darakuneko/kb_bridge/docs/hardware/kb_bridge_v0.7_dimensions.pdf

X

Y

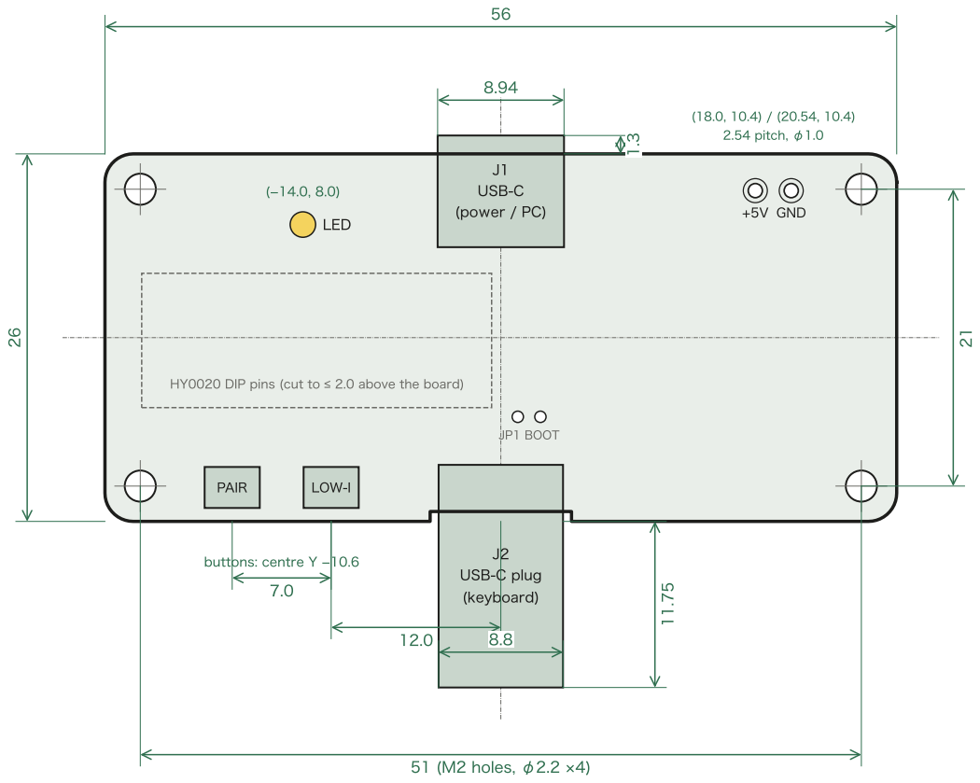
[picture p1: figure]
J1 USB-C; (power / PC); USB-C plug; (keyboard); PAIR; LOW-I; LED; +5V GND; JP1 BOOT; buttons: centre Y −10.6; (18.0, 10.4) / (20.54, 10.4) 2.54 pitch, φ1.0; 51 (M2 holes, φ2.2 ×4)

HY0020 DIP pins (cut to ≤ 2.0 above the board)

## Top view (component side)

## Side view (Y–Z, keyboard side left)

Origin

board centre, X right, +Y towards J1, Z = board bottom (0)

STL

kb_bridge_v0.7_pcba.stl: same frame (mm), HY0020 fitted

Board

56.0 × 26.0 × 1.6, corner R2.0, notch 10 × 0.7 behind J2

Mounting
4 × φ2.2 (M2) at (±25.5, ±10.5)

J1 power / PC

USB-C receptacle, front face Y +14.3 (1.3 out of the edge), Z 0.74–4.85

J2 keyboard
USB-C plug, tip Y −24.75 (11.75 out of the edge), Z 0.29–3.20, centre Z 1.75

Top side

tallest: J1 4.85, buttons 3.54 (TS-1088, pressed from the top), LED 2.70

Bottom
HY0020 DIP board + module down to Z −2.14; keep Z −2.9 free

5V / GND
two φ1.0 holes, 2.54 pitch at (18.0, 10.4) +5V and

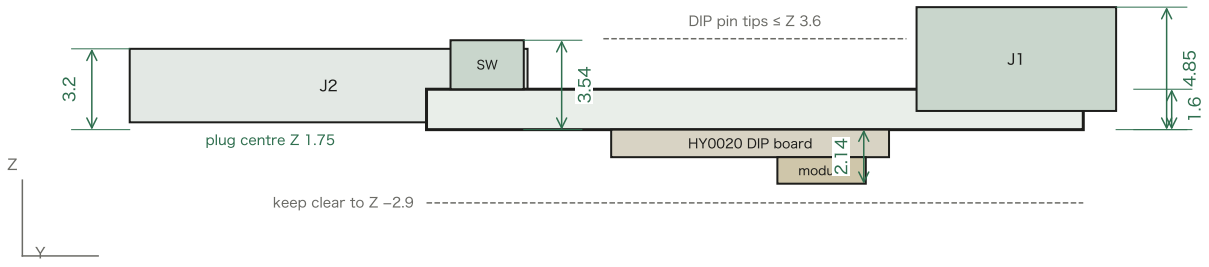
[picture p2: figure]
HY0020 DIP board; module; keep clear to Z −2.9; DIP pin tips ≤ Z 3.6; plug centre Z 1.75

(20.54, 10.4) GND:
power without J1 (4.5–5.5 V; same input as J1,

reverse-protected)

LED
bi-colour (red / green) at (−14.0, 8.0) on the top

side: leave a light hole

Antenna

keep metal away from the HY0020 module (bottom side, Y +0.9 … +4.4)

# KB Bridge v0.7 — PCBA dimensions
