darakuneko/kb_bridge/THIRD_PARTY_NOTICES.md

# Third-party notices

KB Bridge itself is MIT licensed (see `LICENSE`). The firmware binaries published in `docs/firmware/`
also contain the third-party software below; their licenses follow.

- **nRF52832 firmware** (`kb_bridge_*.zip`): built with the Adafruit nRF52 Arduino core 1.7.0 and the
  libraries listed here. The LGPL-2.1 parts of the core are linked statically; the complete source of
  KB Bridge (this repository) and of the core (link below) are public, so the firmware can be rebuilt
  and relinked with a modified core (`fw/build.sh`).
- **CH559 firmware** (`kb_bridge_ch559_*.bin`, also embedded in the nRF firmware): KB Bridge code only,
  built with SDCC; the SDCC runtime library is GPL with a linking exception, which places no conditions
  on the firmware.
- The Nordic SoftDevice and the Adafruit bootloader come pre-installed on the AE-HY0020-DIP and are not
  part of these files (only the SoftDevice API headers are used at build time).

| Component | License | Source |
|---|---|---|
| Adafruit nRF52 Arduino core 1.7.0 (Arduino core files) | LGPL-2.1-or-later | https://github.com/adafruit/Adafruit_nRF52_Arduino |
| Bluefruit52Lib (Adafruit nRF52 core) | MIT | https://github.com/adafruit/Adafruit_nRF52_Arduino |
| InternalFileSystem / Adafruit_LittleFS (Adafruit nRF52 core) | MIT | https://github.com/adafruit/Adafruit_nRF52_Arduino |
| littlefs | BSD-3-Clause | https://github.com/littlefs-project/littlefs |
| FreeRTOS kernel | MIT | https://www.freertos.org |
| Nordic nrfx / MDK | BSD-3-Clause | https://github.com/NordicSemiconductor/nrfx |
| Nordic SoftDevice S132 6.1.1 API headers | Nordic 5-Clause | https://www.nordicsemi.com |

## Adafruit nRF52 Arduino core 1.7.0 (Arduino core files)

License: LGPL-2.1-or-later. Source: https://github.com/adafruit/Adafruit_nRF52_Arduino

```
Copyright (c) 2015 Arduino LLC.  All right reserved.
Copyright (c) 2016 Sandeep Mistry All right reserved.
Copyright (c) 2017 Adafruit Industries. All rights reserved.

This library is free software; you can redistribute it and/or
modify it under the terms of the GNU Lesser General Public
License as published by the Free Software Foundation; either
version 2.1 of the License, or (at your option) any later version.

This library is distributed in the hope that it will be useful,
but WITHOUT ANY WARRANTY; without even the implied warranty of
MERCHANTABILITY or FITNESS FOR A PARTICULAR PURPOSE.
See the GNU Lesser General Public License for more details.

You should have received a copy of the GNU Lesser General Public
License along with this library; if not, write to the Free Software
Foundation, Inc., 51 Franklin St, Fifth Floor, Boston, MA  02110-1301  USA

Full text: licenses/LGPL-2.1.txt
```

## Bluefruit52Lib (Adafruit nRF52 core)

License: MIT. Source: https://github.com/adafruit/Adafruit_nRF52_Arduino

```
MIT License

Copyright (c) 2016 Adafruit Industries

Permission is hereby granted, free of charge, to any person obtaining a copy
of this software and associated documentation files (the "Software"), to deal
in the Software without restriction, including without limitation the rights
to use, copy, modify, merge, publish, distribute, sublicense, and/or sell
copies of the Software, and to permit persons to whom the Software is
furnished to do so, subject to the following conditions:

The above copyright notice and this permission notice shall be included in all
copies or substantial portions of the Software.

THE SOFTWARE IS PROVIDED "AS IS", WITHOUT WARRANTY OF ANY KIND, EXPRESS OR
IMPLIED, INCLUDING BUT NOT LIMITED TO THE WARRANTIES OF MERCHANTABILITY,
FITNESS FOR A PARTICULAR PURPOSE AND NONINFRINGEMENT. IN NO EVENT SHALL THE
AUTHORS OR COPYRIGHT HOLDERS BE LIABLE FOR ANY CLAIM, DAMAGES OR OTHER
LIABILITY, WHETHER IN AN ACTION OF CONTRACT, TORT OR OTHERWISE, ARISING FROM,
OUT OF OR IN CONNECTION WITH THE SOFTWARE OR THE USE OR OTHER DEALINGS IN THE
SOFTWARE.
```

## InternalFileSystem / Adafruit_LittleFS (Adafruit nRF52 core)

License: MIT. Source: https://github.com/adafruit/Adafruit_nRF52_Arduino

```
The MIT License (MIT)

Copyright (c) 2019 Ha Thach for Adafruit Industries

Permission is hereby granted, free of charge, to any person obtaining a copy
of this software and associated documentation files (the "Software"), to deal
in the Software without restriction, including without limitation the rights
to use, copy, modify, merge, publish, distribute, sublicense, and/or sell
copies of the Software, and to permit persons to whom the Software is
furnished to do so, subject to the following conditions:

The above copyright notice and this permission notice shall be included in
all copies or substantial portions of the Software.

THE SOFTWARE IS PROVIDED "AS IS", WITHOUT WARRANTY OF ANY KIND, EXPRESS OR
IMPLIED, INCLUDING BUT NOT LIMITED TO THE WARRANTIES OF MERCHANTABILITY,
FITNESS FOR A PARTICULAR PURPOSE AND NONINFRINGEMENT. IN NO EVENT SHALL THE
AUTHORS OR COPYRIGHT HOLDERS BE LIABLE FOR ANY CLAIM, DAMAGES OR OTHER
LIABILITY, WHETHER IN AN ACTION OF CONTRACT, TORT OR OTHERWISE, ARISING FROM,
OUT OF OR IN CONNECTION WITH THE SOFTWARE OR THE USE OR OTHER DEALINGS IN
THE SOFTWARE.
```

## littlefs

License: BSD-3-Clause. Source: https://github.com/littlefs-project/littlefs

```
Copyright (c) 2017, Arm Limited. All rights reserved.

Redistribution and use in source and binary forms, with or without modification,
are permitted provided that the following conditions are met:

-  Redistributions of source code must retain the above copyright notice, this
   list of conditions and the following disclaimer.
-  Redistributions in binary form must reproduce the above copyright notice, this
   list of conditions and the following disclaimer in the documentation and/or
   other materials provided with the distribution.
-  Neither the name of ARM nor the names of its contributors may be used to
   endorse or promote products derived from this software without specific prior
   written permission.

THIS SOFTWARE IS PROVIDED BY THE COPYRIGHT HOLDERS AND CONTRIBUTORS "AS IS" AND
ANY EXPRESS OR IMPLIED WARRANTIES, INCLUDING, BUT NOT LIMITED TO, THE IMPLIED
WARRANTIES OF MERCHANTABILITY AND FITNESS FOR A PARTICULAR PURPOSE ARE
DISCLAIMED. IN NO EVENT SHALL THE COPYRIGHT HOLDER OR CONTRIBUTORS BE LIABLE FOR
ANY DIRECT, INDIRECT, INCIDENTAL, SPECIAL, EXEMPLARY, OR CONSEQUENTIAL DAMAGES
(INCLUDING, BUT NOT LIMITED TO, PROCUREMENT OF SUBSTITUTE GOODS OR SERVICES;
LOSS OF USE, DATA, OR PROFITS; OR BUSINESS INTERRUPTION) HOWEVER CAUSED AND ON
ANY THEORY OF LIABILITY, WHETHER IN CONTRACT, STRICT LIABILITY, OR TORT
(INCLUDING NEGLIGENCE OR OTHERWISE) ARISING IN ANY WAY OUT OF THE USE OF THIS
SOFTWARE, EVEN IF ADVISED OF THE POSSIBILITY OF SUCH DAMAGE.
```

## FreeRTOS kernel

License: MIT. Source: https://www.freertos.org

```
The FreeRTOS kernel is released under the MIT open source license, the text of
which is provided below.

This license covers the FreeRTOS kernel source files, which are located in the
/FreeRTOS/Source directory of the official FreeRTOS kernel download.  It also
covers most of the source files in the demo application projects, which are
located in the /FreeRTOS/Demo directory of the official FreeRTOS download.  The
demo projects may also include third party software that is not part of FreeRTOS
and is licensed separately to FreeRTOS.  Examples of third party software
includes header files provided by chip or tools vendors, linker scripts,
peripheral drivers, etc.  All the software in subdirectories of the /FreeRTOS
directory is either open source or distributed with permission, and is free for
use.  For the avoidance of doubt, refer to the comments at the top of each
source file.

License text:
-------------

Copyright (C) 2017 Amazon.com, Inc. or its affiliates.  All Rights Reserved.
Permission is hereby granted, free of charge, to any person obtaining a copy of
this software and associated documentation files (the "Software"), to deal in
the Software without restriction, including without limitation the rights to
use, copy, modify, merge, publish, distribute, sublicense, and/or sell copies of
the Software, and to permit persons to whom the Software is furnished to do so,
subject to the following conditions:

The above copyright notice and this permission notice shall be included in all
copies or substantial portions of the Software.

THE SOFTWARE IS PROVIDED "AS IS", WITHOUT WARRANTY OF ANY KIND, EXPRESS OR
IMPLIED, INCLUDING BUT NOT LIMITED TO THE WARRANTIES OF MERCHANTABILITY, FITNESS
FOR A PARTICULAR PURPOSE AND NONINFRINGEMENT. IN NO EVENT SHALL THE AUTHORS OR
COPYRIGHT HOLDERS BE LIABLE FOR ANY CLAIM, DAMAGES OR OTHER LIABILITY, WHETHER
IN AN ACTION OF CONTRACT, TORT OR OTHERWISE, ARISING FROM, OUT OF OR IN
CONNECTION WITH THE SOFTWARE OR THE USE OR OTHER DEALINGS IN THE SOFTWARE.
```

## Nordic nrfx / MDK

License: BSD-3-Clause. Source: https://github.com/NordicSemiconductor/nrfx

```
Copyright (c) 2017 - 2020, Nordic Semiconductor ASA
All rights reserved.

Redistribution and use in source and binary forms, with or without
modification, are permitted provided that the following conditions are met:

1. Redistributions of source code must retain the above copyright notice, this
   list of conditions and the following disclaimer.

2. Redistributions in binary form must reproduce the above copyright
   notice, this list of conditions and the following disclaimer in the
   documentation and/or other materials provided with the distribution.

3. Neither the name of the copyright holder nor the names of its
   contributors may be used to endorse or promote products derived from this
   software without specific prior written permission.

THIS SOFTWARE IS PROVIDED BY THE COPYRIGHT HOLDERS AND CONTRIBUTORS "AS IS"
AND ANY EXPRESS OR IMPLIED WARRANTIES, INCLUDING, BUT NOT LIMITED TO, THE
IMPLIED WARRANTIES OF MERCHANTABILITY AND FITNESS FOR A PARTICULAR PURPOSE
ARE DISCLAIMED. IN NO EVENT SHALL THE COPYRIGHT HOLDER OR CONTRIBUTORS BE
LIABLE FOR ANY DIRECT, INDIRECT, INCIDENTAL, SPECIAL, EXEMPLARY, OR
CONSEQUENTIAL DAMAGES (INCLUDING, BUT NOT LIMITED TO, PROCUREMENT OF
SUBSTITUTE GOODS OR SERVICES; LOSS OF USE, DATA, OR PROFITS; OR BUSINESS
INTERRUPTION) HOWEVER CAUSED AND ON ANY THEORY OF LIABILITY, WHETHER IN
CONTRACT, STRICT LIABILITY, OR TORT (INCLUDING NEGLIGENCE OR OTHERWISE)
ARISING IN ANY WAY OUT OF THE USE OF THIS SOFTWARE, EVEN IF ADVISED OF THE
POSSIBILITY OF SUCH DAMAGE.
```

## Nordic SoftDevice S132 6.1.1 API headers

License: Nordic 5-Clause. Source: https://www.nordicsemi.com

```
Copyright (c) 2015 - 2018, Nordic Semiconductor ASA
All rights reserved.

Redistribution and use in source and binary forms, with or without modification,
are permitted provided that the following conditions are met:

1. Redistributions of source code must retain the above copyright notice, this
   list of conditions and the following disclaimer.

2. Redistributions in binary form, except as embedded into a Nordic
   Semiconductor ASA integrated circuit in a product or a software update for
   such product, must reproduce the above copyright notice, this list of
   conditions and the following disclaimer in the documentation and/or other
   materials provided with the distribution.

3. Neither the name of Nordic Semiconductor ASA nor the names of its
   contributors may be used to endorse or promote products derived from this
   software without specific prior written permission.

4. This software, with or without modification, must only be used with a
   Nordic Semiconductor ASA integrated circuit.

5. Any software provided in binary form under this license must not be reverse
   engineered, decompiled, modified and/or disassembled.

THIS SOFTWARE IS PROVIDED BY NORDIC SEMICONDUCTOR ASA "AS IS" AND ANY EXPRESS
OR IMPLIED WARRANTIES, INCLUDING, BUT NOT LIMITED TO, THE IMPLIED WARRANTIES
OF MERCHANTABILITY, NONINFRINGEMENT, AND FITNESS FOR A PARTICULAR PURPOSE ARE
DISCLAIMED. IN NO EVENT SHALL NORDIC SEMICONDUCTOR ASA OR CONTRIBUTORS BE
LIABLE FOR ANY DIRECT, INDIRECT, INCIDENTAL, SPECIAL, EXEMPLARY, OR
CONSEQUENTIAL DAMAGES (INCLUDING, BUT NOT LIMITED TO, PROCUREMENT OF SUBSTITUTE
GOODS OR SERVICES; LOSS OF USE, DATA, OR PROFITS; OR BUSINESS INTERRUPTION)
HOWEVER CAUSED AND ON ANY THEORY OF LIABILITY, WHETHER IN CONTRACT, STRICT
LIABILITY, OR TORT (INCLUDING NEGLIGENCE OR OTHERWISE) ARISING IN ANY WAY OUT
OF THE USE OF THIS SOFTWARE, EVEN IF ADVISED OF THE POSSIBILITY OF SUCH DAMAGE.
```
