darakuneko/kb_bridge/docs/hardware/kb_bridge_v0.7_pcba.stl

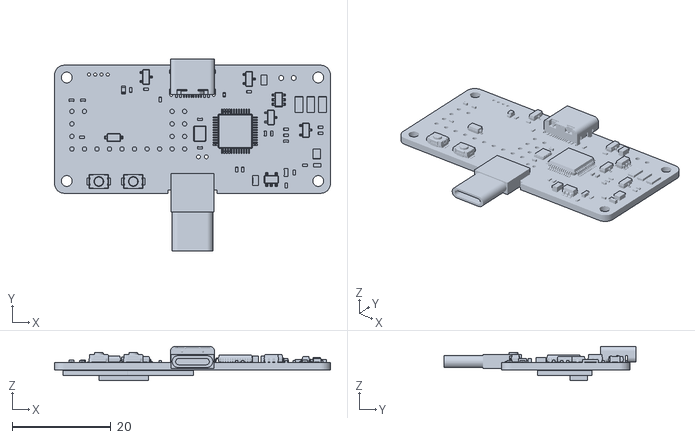
[picture p3: CAD file, 2026-10-29]
docs/hardware/kb_bridge_v0.7_pcba.stl
56.0 x 39.1 x 6.98
