darakuneko/kb_bridge/(commit log)

2026-10-29 KB Bridge firmware, flashing pages and build guide
    [kb_bridge_v0.7_pcba.stl]
2026-10-29 Drop firmware 0.2.0 (test USB PID) from the published list
2026-10-29 v0.7 only: drop v0.6 code paths, the ISP pending flag and 0.2.0 leftovers; MODEL_NAME v0.7; retry / clone-locally advice for failed writes
    [ble.cpp, ch559_isp.cpp, ch559_isp.h, config.h, kb_bridge.ino, main.c]
2026-10-29 Guide: case ships with inserts fitted; 5V pin voltage is a guide value, check on the real supply
2026-10-29 Japanese guide: case quantity 1 組
2026-10-29 Guide: reference current draw and battery-life note
2026-10-29 Guide: typing current varies with the keyboard
2026-10-29 Describe KB Bridge as for any wired USB keyboard, not only QMK / Vial
2026-10-29 Scope: wired USB-C keyboards, plus the Vial protocol
2026-10-29 Use BLE / wireless instead of the Bluetooth name in user-facing text
2026-10-29 Guide: tip on reinforcing J2 with glue / epoxy
2026-11-05 Fix choppy trackpads and watchdog resets: send once per loop, merge mouse reports, keep frames across blocked sends, larger BLE send queue
    [ble.cpp, bridge.cpp, link.cpp]
